ctribe/ECE411-Project/411 Project/nocLock/Graphics/Green_nocLock.JPG

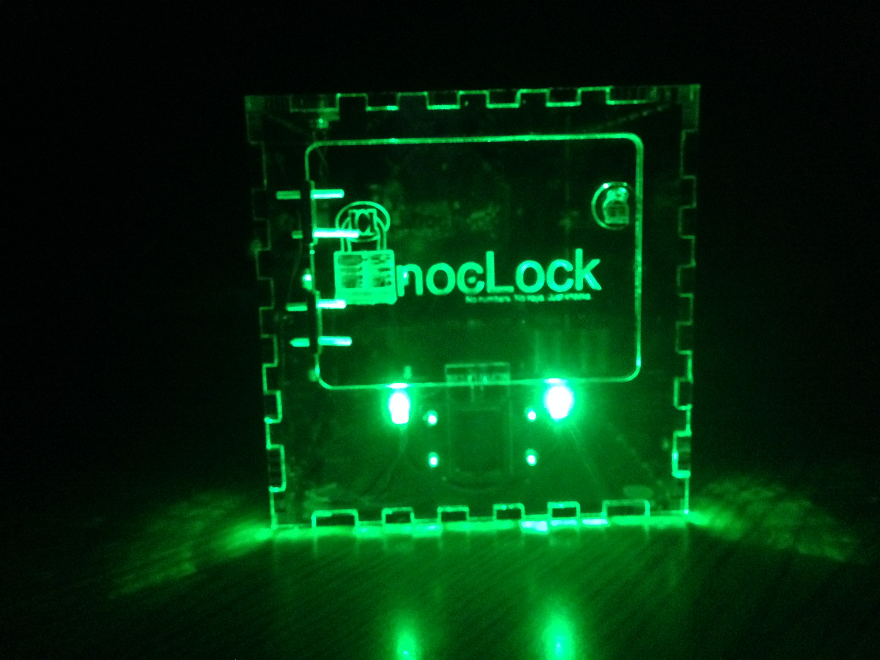
411 Project/nocLock/Graphics/Green_nocLock.JPG
