ctribe/ECE411-Project/411 Project/nocLock/Documentaion/Requirements/nocLock-Requirements.docx

# nocLock Requirements

# Must:

-Unlock with correct knock sequence

-Sense and differentiate knocks from non-knocks

-Store knocks in nonvolatile memory

-Box for locking

-Be able to be locked again

-Have power supply

-Be capable of visual or audio queues for confirmation.

-Have 2-layer PCB with majority surface mount components.

# Should:

-Include enclosure for PCB

-Require user to confirm knock sequence prior to saving

# May:

-Detect two discrete intensities of knocks for added security.

-Have battery-back up and recharging capabilities.
