ctribe/ECE411-Project/411 Project/nocLock/000-Sofware Files/T02_nocLock_Documentation.odt

Knock Lock Program documentation

The inside button will be on PORTB0. The outside button will be on PORTB1. The reset button will be on PORTB6 The inside button controls recording of a new knock sequence, while the outside button signals that someone wants to open the box. The reset button clears EEPROM and returns to the initial state with no knock stored. The locking solenoid will be on PORTB2. The green LED is on PORTB3 and the red LED is on PORTB4. We want the buttons to be an input (0) and the solenoid/LEDS to be an output (1), Thus, the DDRB register should be set as 0x02:

Bit 7 | Bit 6 | Bit 5 | Bit 4 | Bit 3 | Bit 2 | Bit 1 | Bit 0
0 | 0 | 0 | 1 | 1 | 1 | 0 | 0
1 | | | | C

The buttons are active high, so no pull up resistors are needed, and the solenoid must be initially off. The PORTB register looks like this when the solenoid is off:

Bit 7 | Bit 6 | Bit 5 | Bit 4 | Bit 3 | Bit 2 | Bit 1 | Bit 0
0 | 0 | 0 | 0 | 0 | 0 | 0 | 0
0 | | | | 0

Similarly, when the solenoid is on, the PORTB register looks like this:

Bit 7 | Bit 6 | Bit 5 | Bit 4 | Bit 3 | Bit 2 | Bit 1 | Bit 0
0 | 0 | 0 | 0 | 0 | 1 | 0 | 0
0 | | | | 4

The PINB register holds the current state of the ports. In this case, when the inside button is pressed, bit 0 will be a 1. When the outside button is pressed, bit 1 will be a 1. When the reset button is pressed, bit 6 will be a 1. All buttons are active high.

In the CLKPR register, set the CLKPCE bit. Immediately after, set the CLKPR register to 0. This changes the clock divisor to 1, giving us a 8MHz internal clock.

For the timer, we need to set the CTC bit in the TCCR0A register. This will clear the timer and restart it every time the timer reaches the value we want. This allows us to interrupt every 1ms.

Setting the OCR0A (compare) register to 125 makes the timer generate an interrupt every 1ms. Can use this site here to calculate the ticks: http://eleccelerator.com/avr-timer-calculator

To enable an interrupt every time our compare value is met, we need to set bit OCIE0A in the TIMSK0 register. We also need to include the <avr/interrupt.h> library and use the sei() function to enable global interrupts. Use cli() to disable global interrupts.

We then need to set the pre-scaler to 64 in the TCCR0B register. To do this, we set CS01 and CS00 to a 1. This starts the counter, so set it last.

The ISR() function is the interrupt service routine. This is what is used to increment the counter for how many milliseconds we are currently at. We need to use TIMER0_COMPA_vect in the ISR() to check for the interrupt.

Currently, the maximum number of knocks is 100. That could change, though. The function that compares the two knock sequences to unlock the door has a threshold of 200ms on each side of the stored value currently. This gives the user a 400ms window to input each of the knocks in the sequence.

Use the ADMUX register to setup the A to D converter reference voltage and choose the correct signal. I'm using ADC 5 currently and we need to set bit 6 to a 1 and bits 2 and 0 to a 1 for channel 5.

Next, I need ADCSRA register. The ADC uses interrupts, so we set that here. We need to set ADEN, which enables the ADC. Also need to set the ADIE bit to enable interrupts from the ADC. We then need to set the pre-scalar value to the max of 128. To do this, set ADPS0-2.

Final thing we need is to disable digital input buffer in the DIDR0 register. To do this, set the ADC5D bit in the register.

At startup, the outside button will open the solenoid for 5 seconds. The inside button will program a knock sequence. Once the knock sequence has been confirmed, the sequence will be written to eeprom and the box will lock. Pressing the outside button will now wait for the knock sequence to be entered. If the sequence matches, the solenoid opens for 5 seconds. Pressing the inside button will again record a new knock sequence in the same way it did before.

Pressing the reset button erases eeprom and resets the program back to its initial state. The outside button will open the door again for 5 seconds and the inside button will program a new knock. The reset button is located inside, so people cannot use it to break into the box.
