ctribe/ECE411-Project/411 Project/nocLock/Documentaion/Presentation/T02_PresentationRev4.pptx

## T02 nocLock

Travis, jaime, Sean, Cameron

## Agenda

- Project Motivation and Need
- Design
- Implementation
- Testing
- Results
- Contributions and Lessons Learned
- Q/A
- Demo

## Problem & Objective

- Problem: Create an interesting alternative to traditional locking methods.
- Objective: Work as a team to design, construct, and demonstrate a prototype that fulfills course requirements.

## Possible Solution

1. RFID
2. Card Key
3. NES controller
4. Biometric Scanner

## Our Solution

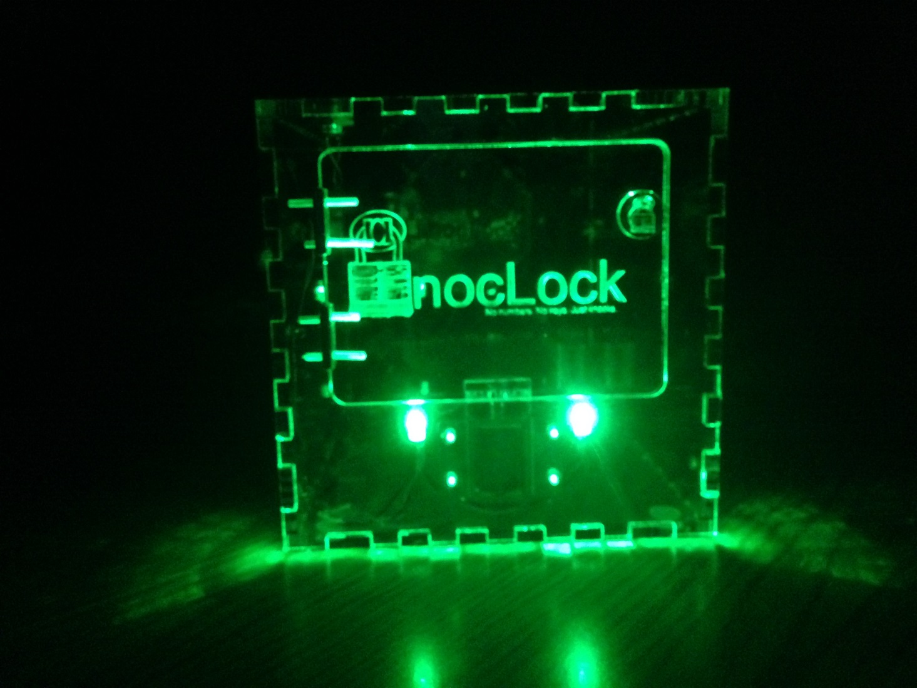
[picture p10: figure]

## Requirements

- Device must lock and unlock.
- Device must differentiate between many distinct knock sequences.
- Device must be reliable. (i.e. stay locked/unlocked when expected)
- Device should be user friendly and intuitive.
- Device must be safe to operate.
- Device must be durable.

## Approach/Overview of Project

- Made decisions as a group
  - Multiple Decision Methods
- Work was done by teams of two
  - Design
  - Verification
- Consistent meeting times
  - Met every Friday

## Inspiration & Research

- Inspiration
  - Idea inspired by Adafruit ‘Secret Knock Detector’
- Research
  - Bob Pease
    - Solenoid driver circuit
  - Various Youtube Videos
    - Working with AVR
    - Timers, ADC, Interrupts, etc.

## System Design

## Design Approach

- Started with top down design
- Block Diagram/Flow Chart
- Modular design methodology
- Concurrent Engineering

## Hardware Level 0/Level 1

## Sensor Input

- Piezo element for knock
sensor.
- Protects uC from >5v

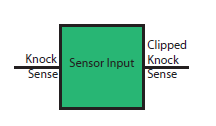
[picture p11: figure]

## Unlock Module

- Depends on lock
- Deliver large current
to solenoid.
- Various driver options
  - Relay
  - Darlington Pair
  - MOSFETs

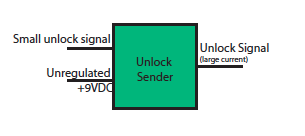
[picture p12: figure]

## Microcontroller

- Central Module
- Various choices
  - Cost
  - Simplicity
  - Availability
- Decided lowest cost as primary concern

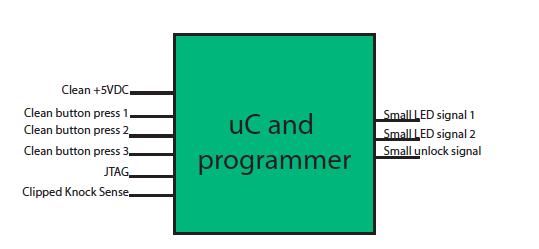
[picture p13: figure]

## Slide 15

Software Flowchart


## Software Algorithms

- Knock Detection
  - ADC threshold
  - Knock Sensor Debounce
  - Timer starts after initial knock
  - Each Knock is stored at current time value
  - Knock combination is a collection of times
- Knock Compare
  - Compare number of knocks
  - Compare timer values

## Software Implemtation

## Read Knocks

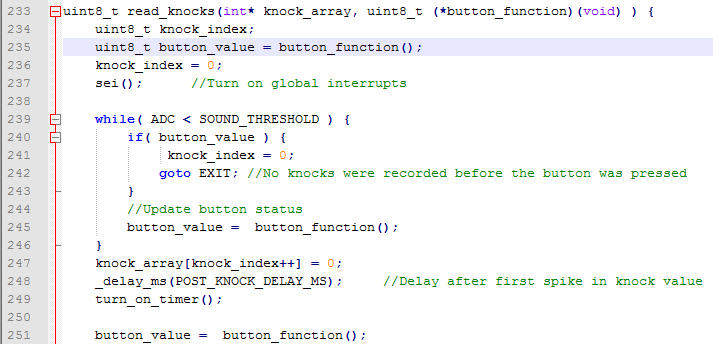
[picture p14: figure]

## Read Knocks cont.

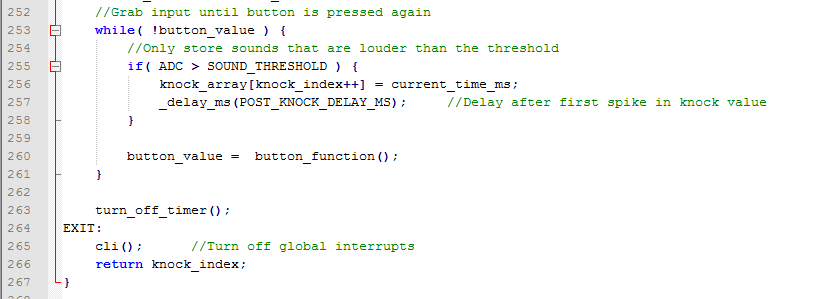
[picture p15: figure]

## Compare Knocks

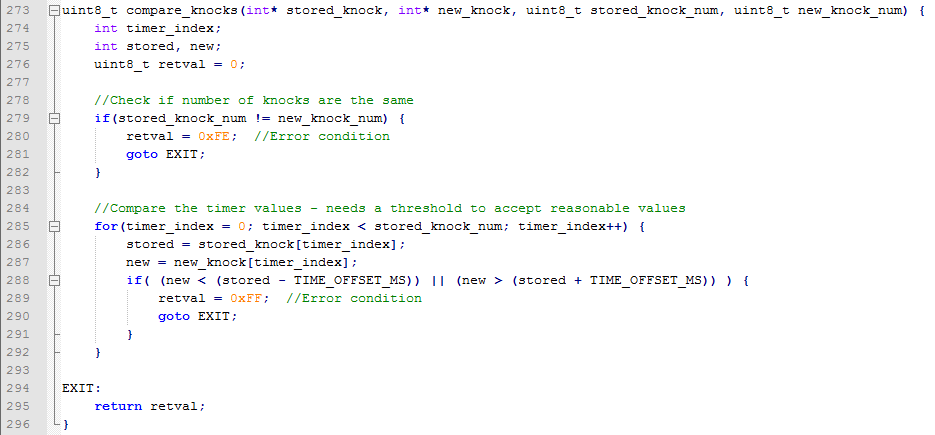
[picture p16: figure]

## Hardware Implementation

## Knock Sense Subsystem

- Protection diode clips voltage
- Current drain
- Connects via connector

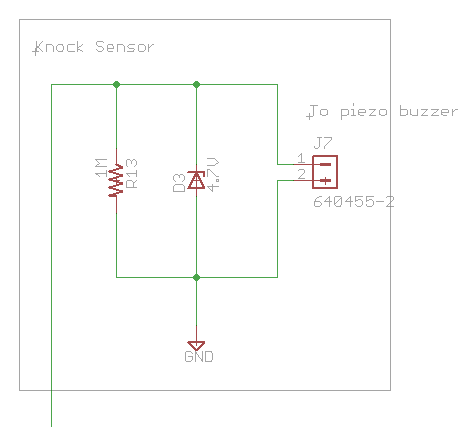
[picture p17: figure]

## Slide 23

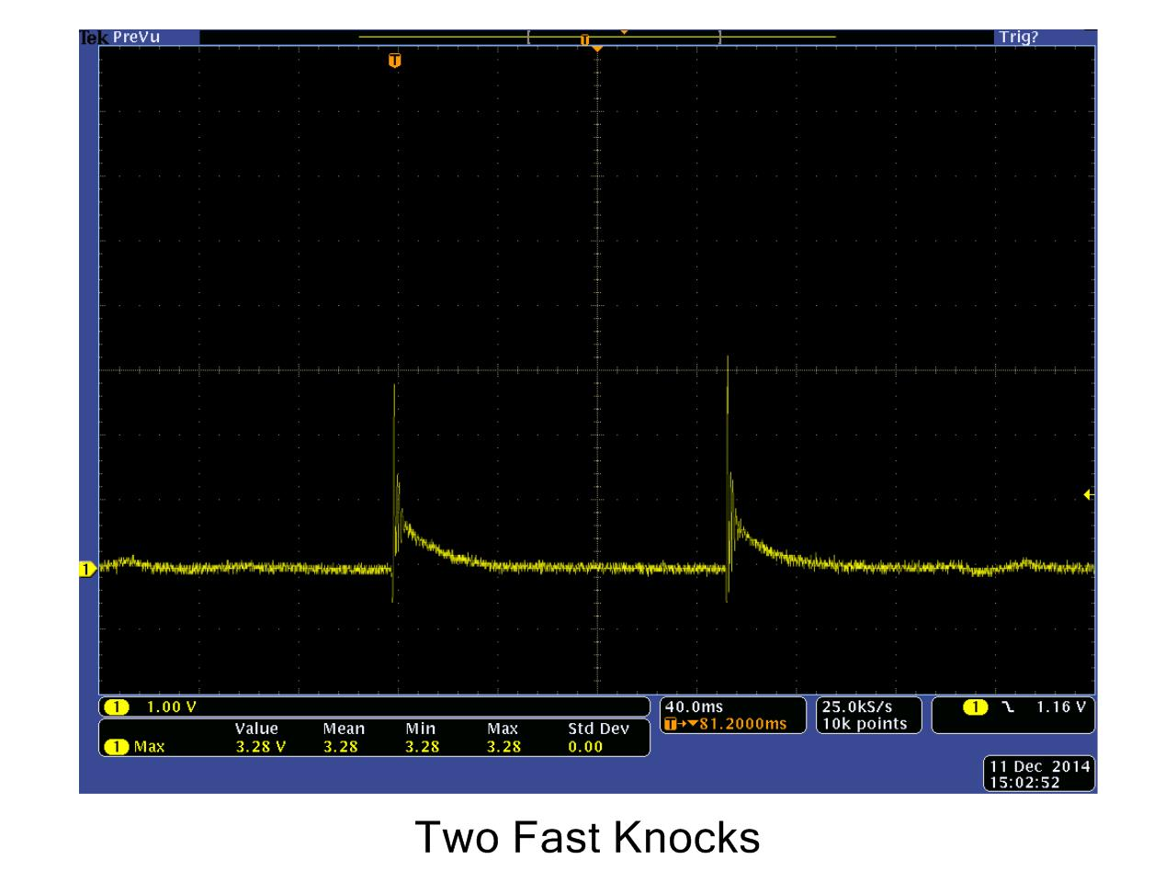
[picture p18: figure]

## Solenoid Subsystem

- MOSFET Switch
- Clamp diode
- Lowers voltage drop across solenoid
- Reduction of current consumption from 600mA to 300mA

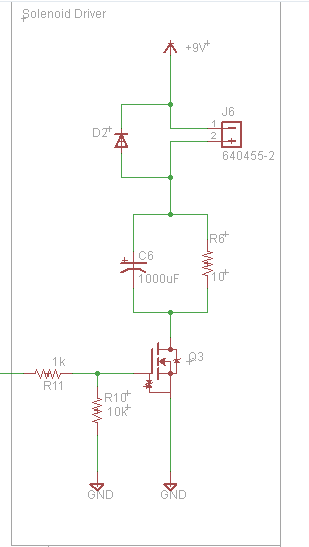
[picture p19: figure]

## Slide 25

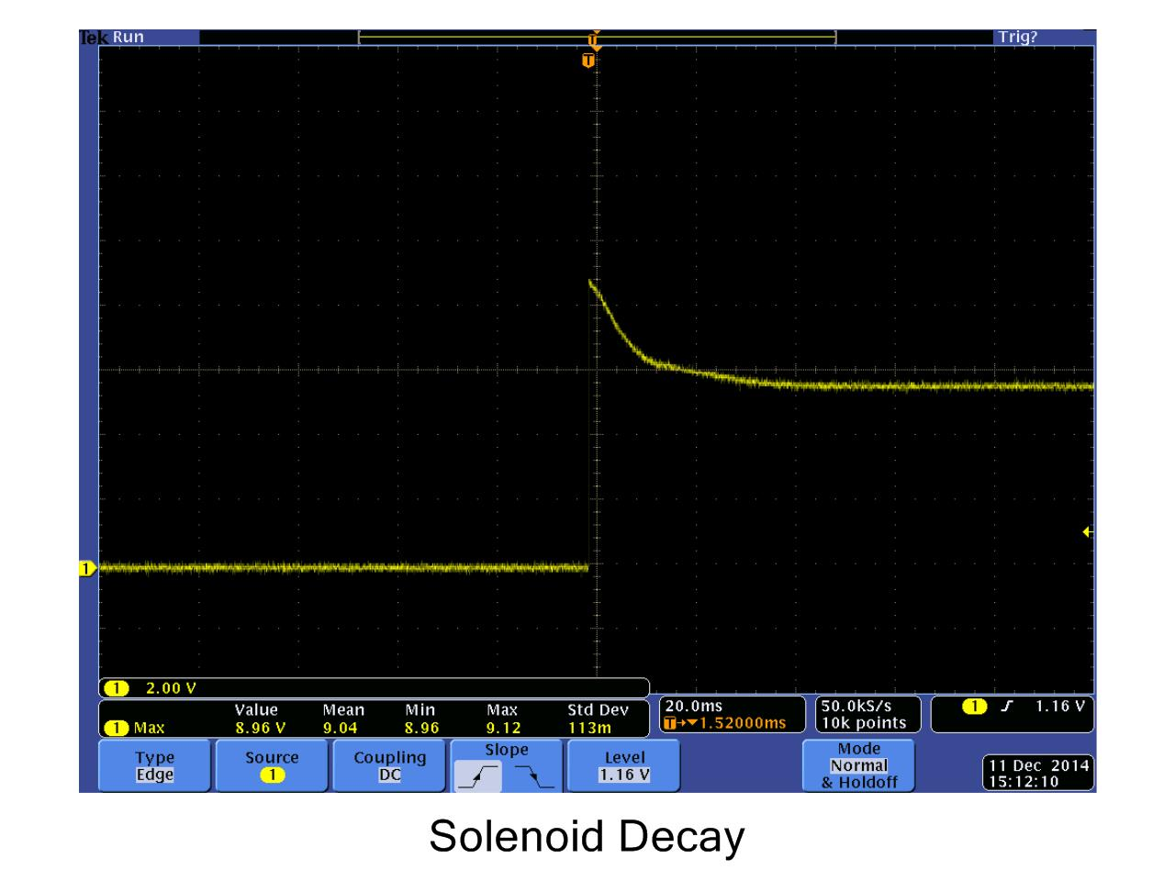
[picture p20: figure]

## Microcontroller Subsystem

- ATMega 88A
- Isolated digital/ADC power supplies
- Low cost and adequate memory
  - EEPROM too
- Dev. tools available

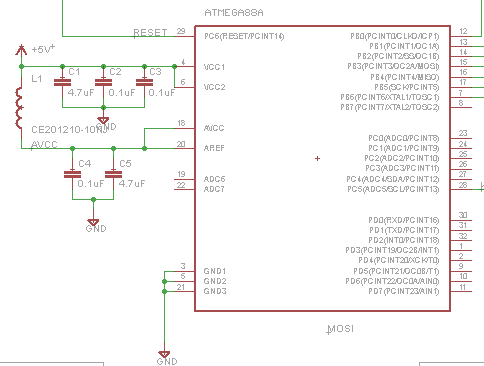
[picture p21: figure]

## PCB Layout

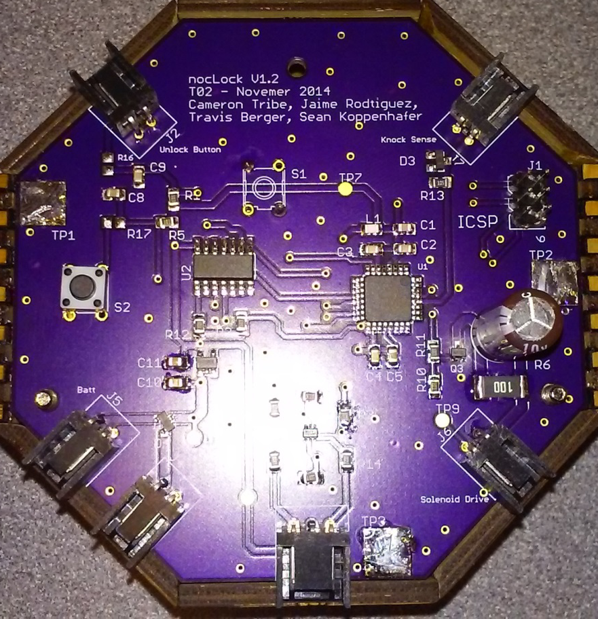
[picture p22: figure]
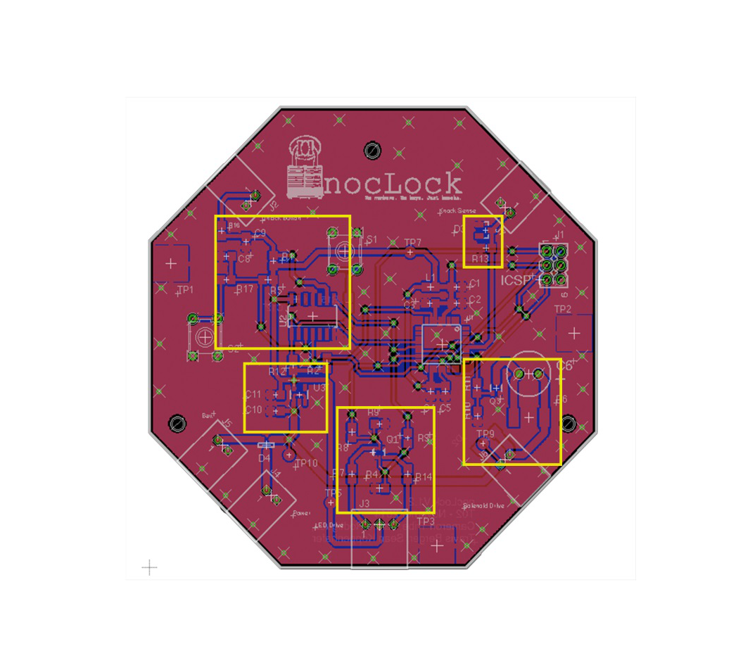
[picture p23: figure]

Button
Inputs

Sensor
input

Power
Supply

Solenoid

LED’s

## PCB Enclosure

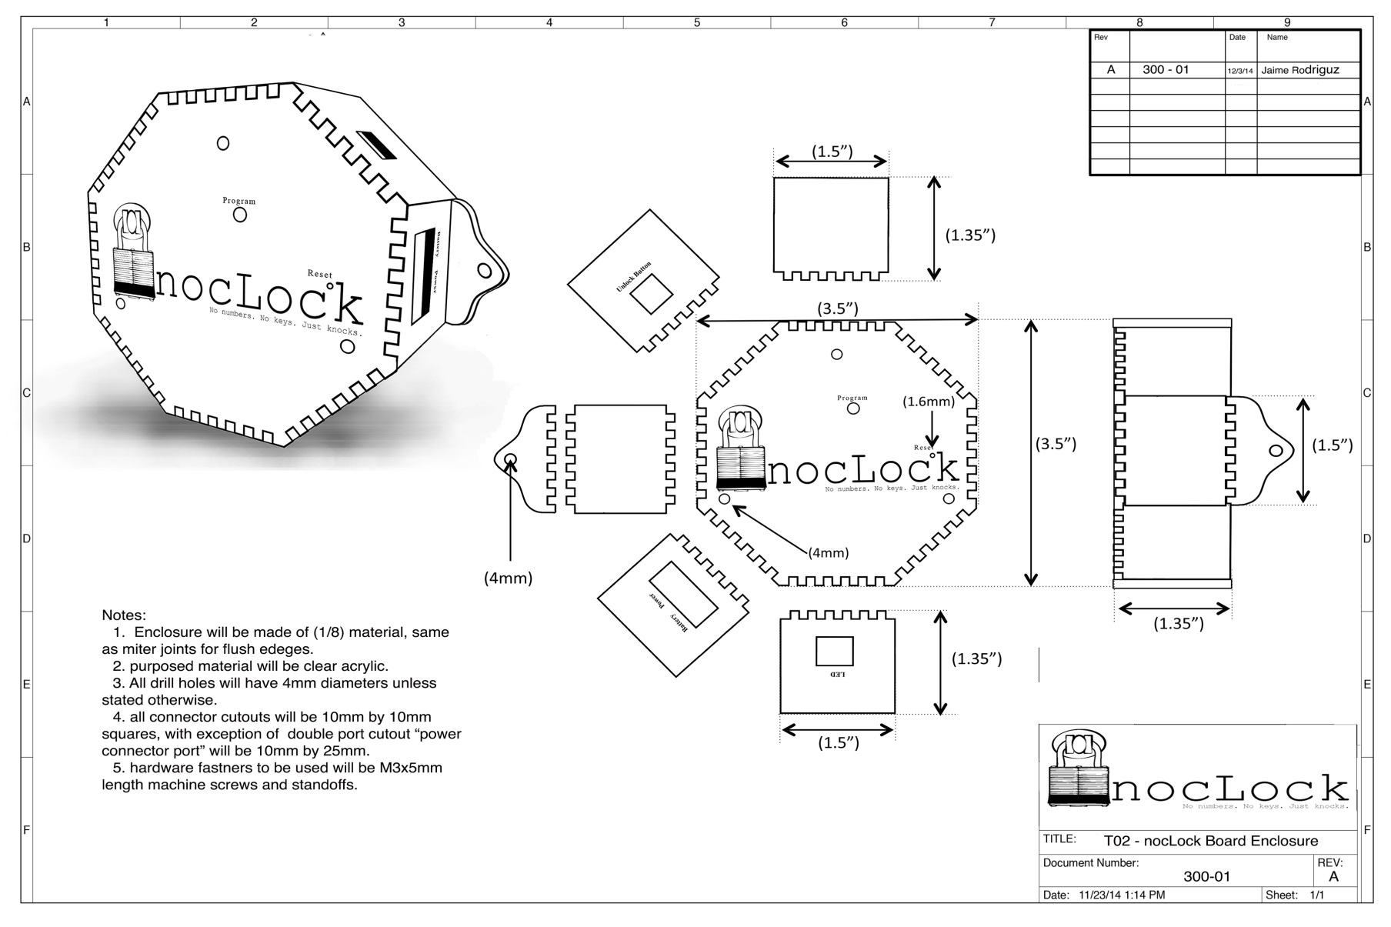
[picture p24: figure]

## Testing

## Testing Overview

- Concurrent Engineering
  - Verification
  - Characterization
- Test Categories
  - Modular Testing
  - Software Testing
  - Integration Testing
  - User Testing

## Concurrent Engineering

- Verification
  - Testing was started during the design phase in order to verify designs
  - When any changes were made to a design, the new design was verified before integrating that design with anything else
- Characterization
  - Characterized performance of key components

## Test Categories

- Modular Tests
  - Modular Testing was done to remove as many variables as possible in order to identify bugs/problems
  - Module test passes were prerequisites for larger integration tests.
- S0ftware Testing
- Integration Tests
  - Integrated modules and tested performance of entire system.
  - Started by using stubs to simulate integration.
- User Testing
  - Observed beta testing of project.

## Results

- Things that worked on the board:
  - Solenoid Driver circuit
  - Power Supply
  - LED Driver
- Things that DIDN’T work on the board
  - Buttons
  - Software for buttons
    - Program button
  - ICSP

## Results

- Things that worked in our group:
  - Communication
  - Work balance
  - Flexibility
- Things that DIDN’T work in our group
  - Github for schematics
  - Working too soon
  - Communication

## Contributions

- Cameron
- Travis
- Sean
- Jaime

## Lessons - Cameron

- Eagle CAD
  - Library management
  - PCB Layout
  - Schematic Drawing
- Simple CAD drawings
- EPL equipment
- Microcontroller interfacing
- Project management
