ctribe/ECE411-Project/411 Project/nocLock/Documentaion/Presentation/T02-Presentation-Cameron.pptx

## Prior Work

- Adafruit
  - Main project idea only
  - No code
  - Ideas for circuits
- Bob Pease
  - Solenoid snubber circuit

## Design: Hardware

- Level 0/Level 1 Block diagram
