ctribe/ECE411-Project/411 Project/nocLock/Documentaion/WPR/wk5/T02_WPR_Berger_11_23.docx

Weekly Progress Report

T02

Travis Berger

Week ending 11/23/2014

Completed Tasks:

1. Developed test plan and a test case for board testing and homework assignment.
2. Assembled two PCB’s and tested using test plan.
3. Reviewed PCB enclosure design before fabrication.

Tasks to Be Completed Next Week:

1. Put together and test a fully completed prototype in final enclosure.
2. Finish assembling the other PCB’s.
3. Fix any problems that arise from enclosure.
4. Help debug problem with software during unlock mode.
