ctribe/ECE411-Project/411 Project/nocLock/Documentaion/WPR/wk4/WPR_Berger_11_16.docx

Weekly Progress Report

T02

Travis Berger

Week ending 11/16/2014

Completed Tasks:

1. Layed out basic structure of final presentation.
2. Completed System Design and Modeling homework assignment.
3. Reimbursed Cameron Tribe for purchasing components and boards.
4. Received board 11/14. Powered up board and tested resulting in a few board modifications which are doable and won’t affect time schedule.

Tasks to Be Completed Next Week:

1. Develop test plan for board testing and homework assignment.
2. Assemble all PCB’s and test using test plan.
3. Review PCB enclosure design before fabrication.
