ctribe/ECE411-Project/411 Project/nocLock/Documentaion/WPR/wk3/WPR_Berger_11_9.docx

Weekly Progress Report

T02

Travis Berger

Week ending 11/9/2014

Completed Tasks:

1. Installed Microsoft Project and familiarized myself with the software.
2. Created Project Schedule.
3. Reviewed teammates PCB layout and verified it.

Tasks to Be Completed Next Week:

1. Layout basic structure of final Presentation.
2. Complete System Design and Modeling homework assignment.
3. Reimburse Cameron Tribe for purchasing components and boards.
4. Start board assembly if boards come back from OSH Park.
