ctribe/ECE411-Project/411 Project/nocLock/Documentaion/System Design/L0-L1.pdf

# nocLock

Knock Sense
Programmer

Battery +9VDC
Wall Wart +9VDC
Button 1
Button 2
Button 3
Knock Sense
Programmer

LED 1

(large current)
LED 2

(large current)
Unlock Signal

(large current)

# Level 0:

# Level 1:

uC and
programmer

LED
Driver
1

LED
Driver
2

Internal
Power Supply

Unlock
Sender

Sensor Input

## nocLock

Battery +9VDC
Wall Wart +9VDC

Button 1

Button 2
Button 3

Knock Sense

Programmer

LED 1
(large current)

LED 2
(large current)

Unlock Signal
(large current)

Source
Selection

Button
Debounce 1

Button
Debounce 2

Button
Debounce 3
