ctribe/ECE411-Project/411 Project/nocLock/Documentaion/System Design/L1-L0.pdf

# uC and programmer

LED
Driver
n

Button
Debounce
n

Internal
Power Supply

Unlock
Sender

Sensor Input

Button n | Clean button press
Clean +5VDC

Small unlock signal

Small LED signal

Knock
Sense

Clipped
Knock
Sense

Clean +5VDC
Clean button press 1
Clean button press 2
Clean button press 3
JTAG
Clipped Knock Sense

Small LED signal 1
Small LED signal 2
Small unlock signal

# Level 0:

## of previous L1

Source
Selection

Battery +9VDC
Wall Wart+9VDC | Unregulated
| +9VDC

Unregulated
+9VDC

Unregulated
+9VDC

Unlock Signal
(large current)

LED n
(large current)
Clean +5VDC
