ctribe/ECE411-Project/411 Project/nocLock/Documentaion/Presentation/T02_PresentationRev2.pptx

## T02 nocLock

Trampus, Jaimus, Shampus, Cameronmpus

## Agenda

- Project Motivation and Need
- Design
- Implementation
- Testing
- Results
- Contributions and Lessons Learned
- Q/A
- Demo

## Problem & Objective

- Problem: Create an interesting alternative to traditional locking methods.
- Objective: Work as a team to design, construct, and demonstrate a small project that fulfills course requirements.

## Possible Solution

1. RFID
2. Card Key
3. NES controller
4. Biometric Scanner

## Our Solution

- <PICTURE PENDING>

## Requirements

- Device must lock and unlock.
- Device must differentiate between many distinct knock sequences.
- Device must be reliable. (i.e. stay locked/unlocked when expected)
- Device should be user friendly and intuitive.
- Device must be safe to operate.
- Device must be affordable.
- Device must be durable.

## Approach/Overview of Project

- Made decisions as a group
  - Multiple Decision Methods
- Work was done by teams of two
  - Design
  - Verification
- Consistent meeting times
  - Met every Friday

## Inspiration & Research

- Inspiration
  - Idea inspired by Adafruit ‘Secret Knock Detector’
- Research
  - Bob Pease
    - Solenoid snubber circuit
  - Various Youtube Videos
    - Working with AVR
    - Timers, ADC, Interrupts, etc.

## System Design

## Design Approach

- Started with top down design
- Block Diagram/Flow Chart
- Modular design methodology
- Concurrent Engineering

## Hardware Level 0/Level 1

## Power source select

- Instant Backup
- Option for charging
- Decided to opt out of battery charging
  - Lower parts count
  - Lower total cost
  - Decided it would be unnecessary

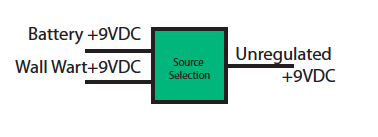
[picture p25: figure]

## Unlock Sender

- Depends on lock
- Deliver large current
to solenoid.
- Various driver options
  - Relay
  - Darlington Pair
  - Mosfet


## Internal power supply

- Produce a clean
voltage supply.
- IC regulators
- Low cost as possible

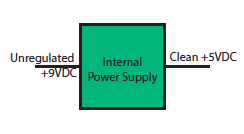
[picture p26: figure]

## LED Driver

- General purpose
switching.
- LED types
  - Individual LEDs
  - Common Anode

## Button Debounce

- Remove button bounce
- Could have been S/W
- Decided to include hardware debounce functionality.

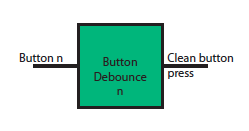
[picture p27: figure]

## microcontroller

- Central Module
- Various choices
  - Cost
  - Simplicity
  - Availability
- Decided lowest cost as primary concern


## Slide 18

Software Flowchart


## Software Algorithms

- Knock Detection
  - ADC threshold
  - Knock Sensor Debounce
  - Timer starts after initial knock
  - Each Knock is stored at current time value
  - Knock is a collection of times
- Knock Compare
  - Compare number of knocks
  - Compare timer values

## Implementation

## Microcontroller Subsystem

- ATMega 88A
- Isolated digital/ADC power supplies
- Low cost and adequate memory
  - EEPROM too
- Dev. tools available


## Solenoid Subsystem

- MOSFET Switch
- Clamp diode
- Lowers voltage drop across solenoid
- Reduction of power consumption from 400mA to 200mA


## Knock Sense Subsystem

- Protection diode clips voltage
- Current drain
- Connects via connector

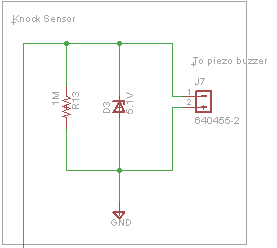
[picture p28: figure]

## Button Debounce

- RC circuit for smoothing bounces.
- Schmidt trigger to create a fast rising edge
- Combination removes button bounces

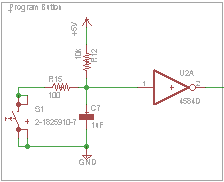
[picture p29: figure]

## LED Driver Subsystem

- Dual MOSFET
- Designed to drive a common anode LED
  - Bi-Color LED
- Connector allows exchangeable LEDs

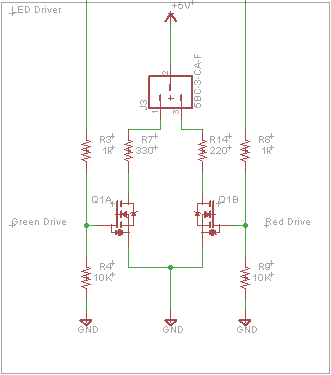
[picture p30: figure]

## PCB Layout


Button
Inputs

Sensor
input

Power
Supply

Solenoid

LED’s

## PCB Enclosure


## Lock Box Design

## Read Knocks


## Read Knocks cont.


## Compare Knocks


## Testing

## Testing Overview

- Concurrent Engineering
  - Verification
  - Characterization
- Test Categories
  - Modular Testing
  - Software Testing
  - Integration Testing
  - User Testing

## Concurrent Engineering

- Verification
  - Testing was started during the design phase in order to verify designs
  - When any changes were made to a design, the new design was verified before integrating that design with anything else
- Characterization
  - Characterized performance of key components

## Test Categories

- Modular Tests
  - Modular Testing was done to remove as many variables as possible in order to identify bugs/problems
  - Module test passes were prerequisites for larger integration tests.
- S0ftware Testing
- Integration Tests
  - Integrated modules and tested performance of entire system.
  - Started by using stubs to simulate integration.
- User Testing
  - Observed beta testing of project.

## Results

- Things that worked on the board:
  - Solenoid Driver circuit
  - Power Supply
  - LED Driver
- Things that worked in our group:
  - Communication
  - Work balance
  - Flexibility

## Results

- Things that DIDN’T work on the board
  - Buttons
  - Software for buttons
    - Program button
  - ICSP
- Things that DIDN’T work in our group
  - Github for schematics
  - Working too soon
  - Communication
  - Not enough work

## contributions

- Cameron
- Travis
- Sean
- Jaime

## Lessons - Cameron

- Eagle CAD
  - Library management
  - PCB Layout
  - Schematic Drawing
- Simple CAD drawings
  - EPL equipment
- Microcontroller interfacing
- Project management
