ctribe/ECE411-Project/411 Project/nocLock/Documentaion/Presentation/T02_Presentation.pptx

## T02 nocLock

Trampus, Jaimus, Shampus, Cameronmpus

## Overview of Presentation

- Problem/need
- Design
- etc

## Problem

- Create an interesting alternative to traditional locking methods. < Wording will change>
- Novelty device that is cool.
- Most likely put in proposal or whatever the ambiguous statement is.

## Objectives

- Work as a team to design, construct, and demonstrate a small project.

## Requirements

- Device must lock and unlock.
- Device must differentiate between many distinct knock sequences.
- Device must be reliable. (i.e. stay locked/unlocked when expected)
- Device should be user friendly and intuitive.
- Device must be safe to operate.
- Device must be affordable.
- Device must be durable.

## Approach/Overview of Project

- Made decisions as a group using decision tables with weighted votes for team members. <prob not use this>
- Broke team into two main groups, usually had one partner tackle initial design and one partner verify and help debug design.

## Design

- Top down design based off of Use-Case diagram.
- Created block diagram which helped to isolate different subsystems.
- Designed with a modular approach by designing each subsystem separately.

## Use-Case Map

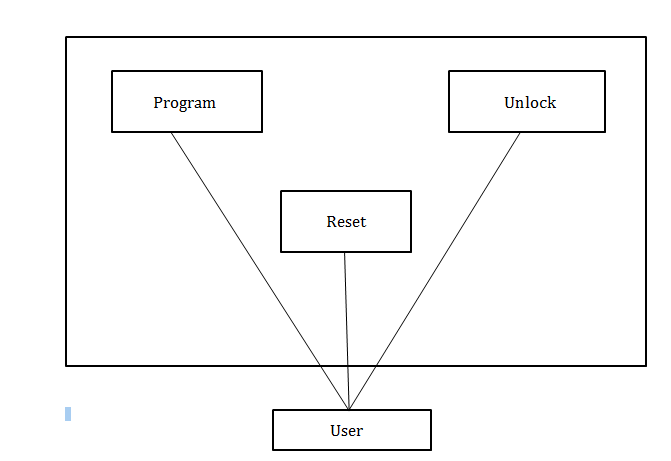
[picture p31: figure]

## Block Diagram


## Solenoid Subsystem

- Overall Design
- Key Parameters inputs outputs etc.
- Integrates with following sub systems: Microcontroller, etc.
- Alternatives: Darlington Pair, Charge Pump.


## Microcontroller Subsystem

- Overall Design
- Key Parameters inputs outputs etc.
- Central Hub integrates with all sub systems.
- Alternatives: Chose this one because we had one, and costs, performance.


## Button System

- Overall Design
- Key Parameters inputs outputs etc.
- Integrates with following sub systems: Microcontroller, etc.
- Alternatives: Darlington Pair, Charge Pump.


## LED Driver Subsystem

- Overall Design
- Key Parameters inputs outputs etc.
- Integrates with following sub systems: Microcontroller, etc.
- Alternatives: Darlington Pair, Charge Pump.

## Knock Sense Subsystem

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

## Software

## Testing

- Testing started with modular testing. This was done to verify design and helped to find bugs in an easier to debug isolated system.
- LED’s were used as stubs in order to integrate the hardware with the software and step through the code.

## Major Setbacks/Bugs

- Button Debounce
- CPU clock speed
- Program Mode
- Knock Sense threshold <voltage>
- Knock Sense Delay <time>
