ctribe/ECE411-Project/411 Project/nocLock/Documentaion/System Design/Blockdiagram.png

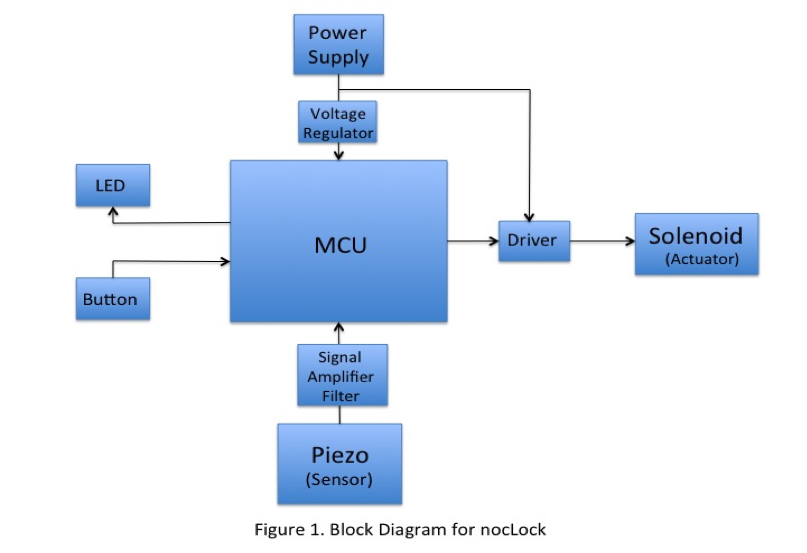
411 Project/nocLock/Documentaion/System Design/Blockdiagram.png
