ctribe/ECE411-Project/411 Project/nocLock/Documentaion/System Design/L1-L0.png

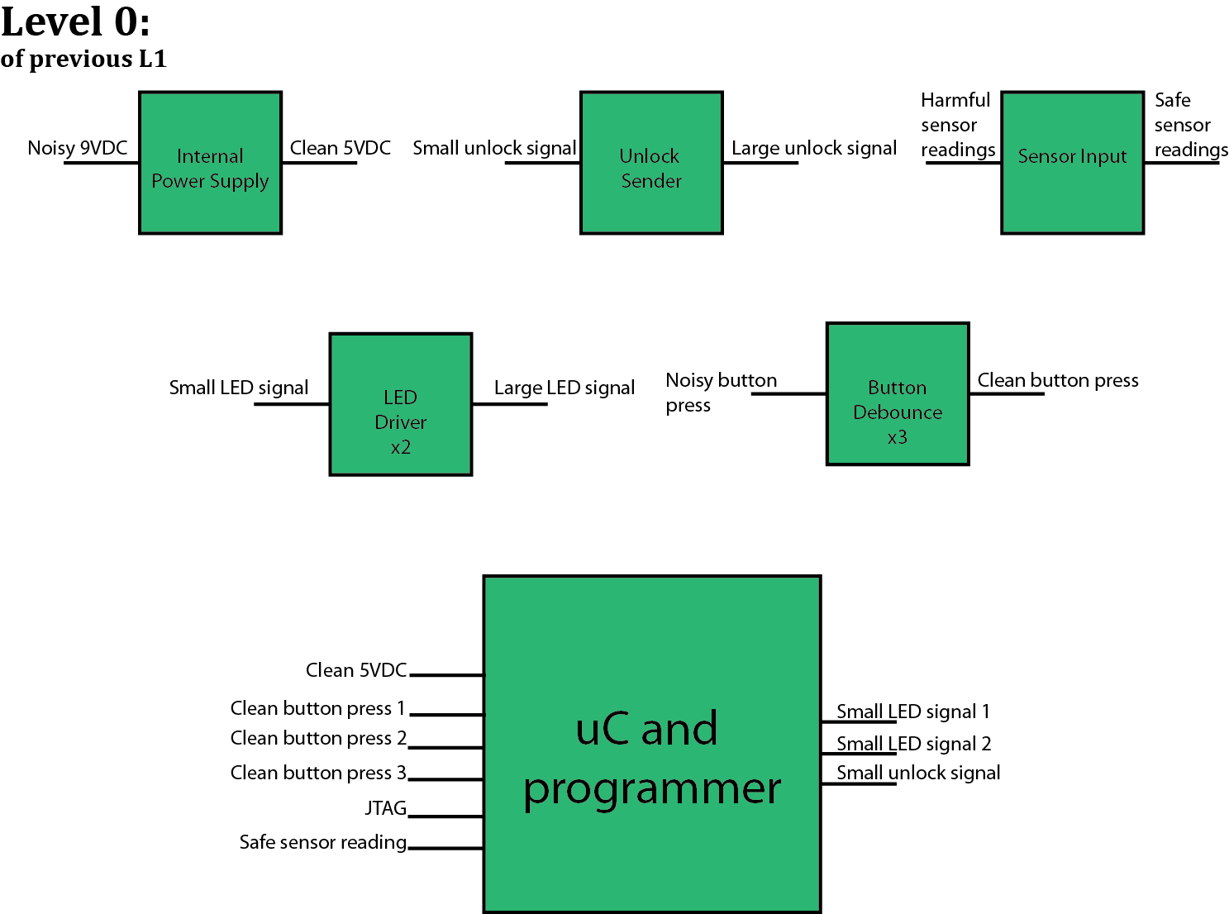
411 Project/nocLock/Documentaion/System Design/L1-L0.png
