ctribe/ECE411-Project/411 Project/nocLock/Graphics/Board.png

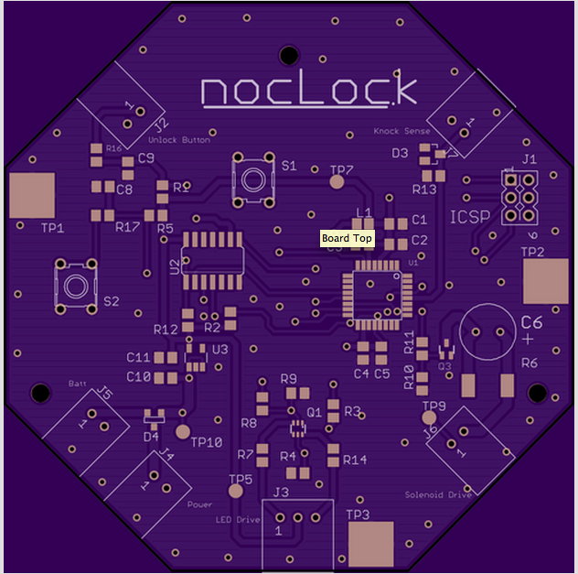
411 Project/nocLock/Graphics/Board.png
