ctribe/ECE411-Project/411 Project/nocLock/Graphics/V1.1Board.png

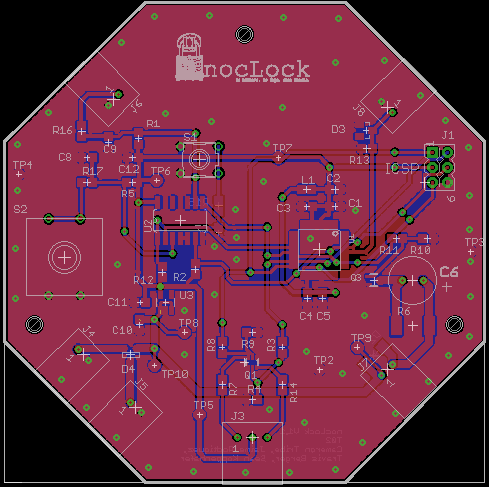
411 Project/nocLock/Graphics/V1.1Board.png
