ctribe/ECE411-Project/411 Project/nocLock/Graphics/Logo/KnockLockLogo.dxf

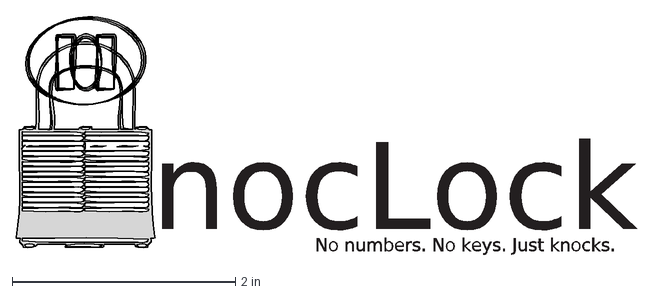
[picture p37: CAD file, 2014-11-10]
411 Project/nocLock/Graphics/Logo/KnockLockLogo.dxf
nocLock
No numbers. No keys. Just knocks.
