ctribe/ECE411-Project/411 Project/nocLock/Documentaion/T02-NocLock_user_manual.docx

NocLock User Manual

First Time Setup

When you first get the NocLock, no knock sequence will be programmed. This allows the user to easily program a knock sequence without having to first enter in a pre-programmed knock sequence from the factory. To program the NocLock with a knock sequence, follow these steps:

1. Press the outside “action” button to open the door of the box.
2. The LED will turn green and the door will unlock for five seconds.
3. Press the inside “program” button, located on the enclosure on the back wall of the box.
4. The LED should now turn yellow, signifying that the NocLock is in program mode. If you would like to exit program mode, press the “program” button again BEFORE entering a knock sequence.
5. Enter in a knock sequence that would like to program the NocLock with.
6. Press the “program” button.
7. The LED will turn green for two seconds, signifying that your knock sequence was recognized.
8. The LED will turn yellow again.
9. The user must now confirm their knock sequence from step 5 before the knock sequence is accepted. Re-enter the same knock sequence from step 5.
10. Press the “program” button.
11. If the knock sequences match, the LED will turn green for two seconds and then turn red. The knock has now been programmed and the box is locked.
12. If the knock sequences do not match, the LED will blink red three times before returning to the initial setup state. Re-start from step 3.

If you successfully programmed your knock sequence, the NocLock will remember your knock sequence until you reprogram the NocLock with a new knock sequence.

Unlocking The NocLock

To unlock the NocLock, you must enter in the currently programmed knock sequence. To do this, follow these steps:

1. Press the outside “action” button.
2. The LED will turn yellow, signifying that the NocLock is listening for knocks. If you would like to exist unlock mode, press the “action” button again BEFORE entering any knocks.
3. Enter the currently programmed knock sequence.
4. Press the outside “action” button.
5. If the knock sequence matches the programmed knock sequence, the LED will turn green and the door will unlock for five seconds.
6. If the knock sequence does not match the programmed knock sequence, the LED will blink red three times before returning to the locked state.

Re-programming The NocLock

If you would like to re-program the NocLock with a new knock sequence, follow these steps:

1. Unlock the box. Follow the steps listed in the section “Unlocking the NocLock”.
2. Press the inside “program” button, located on the enclosure on the back wall of the box.
3. The LED should now turn yellow, signifying that the NocLock is now in program mode. If you would like to exit program mode, press the “program” button again BEFORE entering a knock sequence.
4. Enter in a knock sequence that would like to program the NocLock with.
5. Press the “program” button.
6. The LED will turn green for two seconds, signifying that your knock sequence was recognized.
7. The LED will turn yellow again.
8. The user must now confirm their knock sequence from step 5 before the knock sequence is accepted. Re-enter the same knock sequence from step 4.
9. Press the “program” button.
10. If the knock sequences match, the LED will turn green for two seconds and then turn red. The knock has now been programmed and the box is locked.
11. If the knock sequences do not match, the LED will blink red three times before returning the locked state. If the knock sequences do not match, the original knock sequence will still be stored in the NocLock.

Resetting the NocLock

If for any reason you would like to return to the initial setup state where no knock sequence is programmed, follow these steps:

1. Unlock the box. Follow the steps listed in the section “Unlocking the NocLock”.
2. Use a pin or something small to press the reset button located in the hole in the enclosure at the back of the box.
3. Wait a few seconds for the NocLock to reset itself.

The NocLock will now be in it's initial, factory state.
