ctribe/ECE411-Project/411 Project/nocLock/Documentaion/Test Plan/T02-System_Reliability_test.docx

nocLock System Reliability Test

Test ID: Test Case ?.?

Test Description:

This procedure has been created to test the reliability and robustness of the nocLock system as it is implemented in a general use- case scenario, this test will be accomplished by setting up the entire system to replicate a real life situation. The piezo sensor will be secured to an acrylic board to simulate a knocking surface, which will then be used to repeatedly unlock and open system. This test will not only verify the systems capabilities of differentiating between knock sequences, but will also be crucial in evaluating the behavior of the system after prolonged use.

Equipment:

1. nocLock board
2. Piezo element
3. Solenoid
4. LED indicator
5. Unlock Button
6. 9VDC Voltage Source > 1500mA current rating
7. Acrylic knocking surface (quarter inch)

Reference:

1. T02_nocLock_rev3.sch (for reference)
2. T02 – Test Plan “Parametric Test”
3. T02 System setup diagram (for reference)
4. T02 nocLock general operation.

Setup:

Fully assemble system with all external peripherals as described in “System setup diagram” and securely attach piezo element to acrylic knocking surface. Prepare system by programming the nocLock with a simple 3-knock sequence with a 3 second delay between each individual knock.

Procedure:

- Connect all external peripherals (LED, Solenoid, Unlock button, sensor and power)
- Secure piezo element to knocking surface
- Confirm functionality of all sub-systems using parametric test section from test plan.
- Program system with knock; make sequence as simple as possible.

-Press program button

- knock, count to 3.

- knock, count to 3.

- knock, count to 3.

- Confirm knock sequence; reenter knock sequence.
- Begin testing; use table below for expected system behavior.

Step | Action | Expected Result | Pass/Fail | Comments
1. | Press unlock button | Led will turn from red to yellow to indicate system is listening
2. | Enter knock sequence | N/A
3. | Press unlock button again to end knocking | Led will turn green if knock is accepted, solenoid will engage. Led will turn red if knock is denied and return to stand- by

- Repeat unlocking procedure and record attempt in the form below, after completing test at normal pace, redo procedure without changing the programmed knock sequence but changing knocking pace.
- Vary the Knocking pace.
- slow pace.

- knock, count to 5.

- knock, count to 5.

- knock, count to 5.

- Fast pace.

- knock, count to 0.

- knock, count to 0.

- knock, count to 0.
