ctribe/ECE411-Project/411 Project/nocLock/Documentaion/Test Plan/T02-TestCase 4.1.docx

Function Test: Program Knock

Test ID: Test Case 4.1

Test Description: This function test checks that the basic function of programming a knock sequence is working correctly. To fully test the program function two identical knocks are used to simulate a success and two separate knocks are used to simulate a fail. To conduct this function test reference the Program Use-Case found in the T02 System Design document.

Equipment:

1. Oscilloscope
2. Digital Multi-meter
3. Function Generator
4. Two Channel DC Power Supply
5. AVR Dragon Board

Part(s):

1. Microcontroller module
2. Knock Sensor module
3. Solenoid Drive module
4. Program Button module
5. Unlock Button module
6. Erase EEPROM module
7. LED Sensor module

Reference:

1. T02_nocLock_rev3.sch
2. Test Case 1.1
3. Test Case 1.3
4. Test Case 1.4
5. Test Case 1.5
6. Test Case 1.7
7. Program Use-Case (T02 System Design.doc)

Setup:

The setup for this test case involves the Microcontroller module, Knock Sensor module, Solenoid Drive module, Program Button module, Unlock Button Module, Erase EEPROM module, and LED Sensor module. For instruction on how to setup individual modules refer to the modules test case and/or reference the nocLock Schematic. This test setup will mainly focus on the connections between each module and the microcontroller module.

1. Connect Microcontroller PC5 (Pin 28) to Knock Sense on the Knock Sensor.
2. Connect Microcontroller PB3 (Pin 15) to Green Drive on the LED Module.
3. Connect Microcontroller PB4 (Pin 16) to Red Drive on the LED module.
4. Connect Microcontroller PB0 (Pin 12) to Program on the Program Button Module.
5. Connect Microcontroller PB6 (Pin 7) to U1 on Erase EEPROM Module.

Procedure:

Step | Action | Expected Result | Pass/Fail | Comments
1. | Push Unlock Button. | LED turns green, solenoid activates for five seconds opening nocLock.
2. | Push Program Button | LED turns yellow.
3. | Enter Knock Sequence | LED remains yellow
4. | Push Program Button | LED turns green confirming knock entry, LED turns yellow.
5. | Re-enter Knock Sequence | LED turns green confirming new knock sequence has been successfully program.
6. | Press Reset Button | EEPROM gets Erased.
7. | Push Program Button | LED turns yellow.
8. | Enter Knock Sequence | LED remains yellow
9. | Push Program Button | LED turns green confirming knock entry, LED turns back to yellow.
10. | Enter Different Knock Sequence | LED turns red signifying that the knock sequences were different.
