ctribe/ECE411-Project/411 Project/nocLock/Documentaion/Test Plan/T02-Software_unit_test.odt

Setup:

Ports B0, B1, and B6 are active high input buttons. B0 is the program button, B1 is the action button, and B6 is the reset button. These ports should be grounded initially. Port ADC5 is the A to D converter for the piezo buzzer, which should also be grounded initially. Finally, ports B2, B3, and B4 are output pins. B2 is the solenoid driver, B3 is the green LED, and B4 is the red LED. The micro controller should be programmed with the executable compiled from nocLock.c. Port B4 should be outputting 5V, while ports B2 and B3 are outputting 0V.

Step | Action | Expected Result
1 | Pulse port B1 with 5V to simulate action button press | Port B2 and port B3 output 5V for five seconds. After five seconds, port B2 and B3 go to 0V and port B4 goes to 5V.
2 | Pulse port B0 with 5V to simulate program button press | Port B3 and B4 output 5V
3 | Pulse port ADC5 with 3V at 500ms intervals, four times
4 | Pulse port B0 with 5V to simulate program button press | Port B4 goes to 0V, and B3 goes to 5V for two seconds. After two seconds, B3 and B4 go back to 5V
5 | Pulse port ADC5 with 3V at 500ms intervals, four times
6 | Pulse port B0 with 5V to simulate program button press | Port B4 goes to 0V. Port B3 goes to 5V for two seconds. After two seconds, port B3 goes to 0V and B4 goes to 5V.
7 | Pulse port B0 with 5V to simulate program button press
8
9
10
