ctribe/ECE411-Project/411 Project/nocLock/Documentaion/Test Plan/Avg_nock.jpg

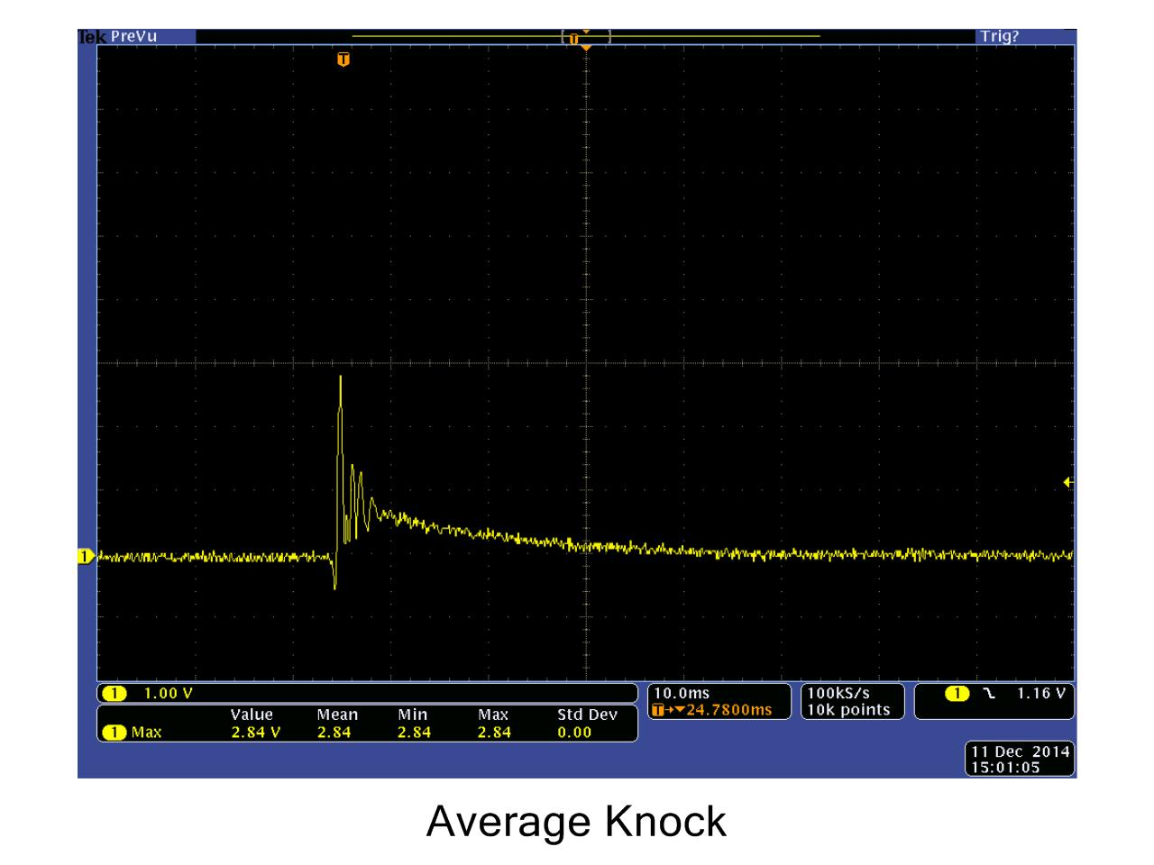
411 Project/nocLock/Documentaion/Test Plan/Avg_nock.jpg
