ctribe/ECE411-Project/411 Project/nocLock/100-Schematic/T02_noclock_rev3.brd

## EAGLE design 411 Project/nocLock/100-Schematic/T02_noclock_rev3.brd (2014-11-15)

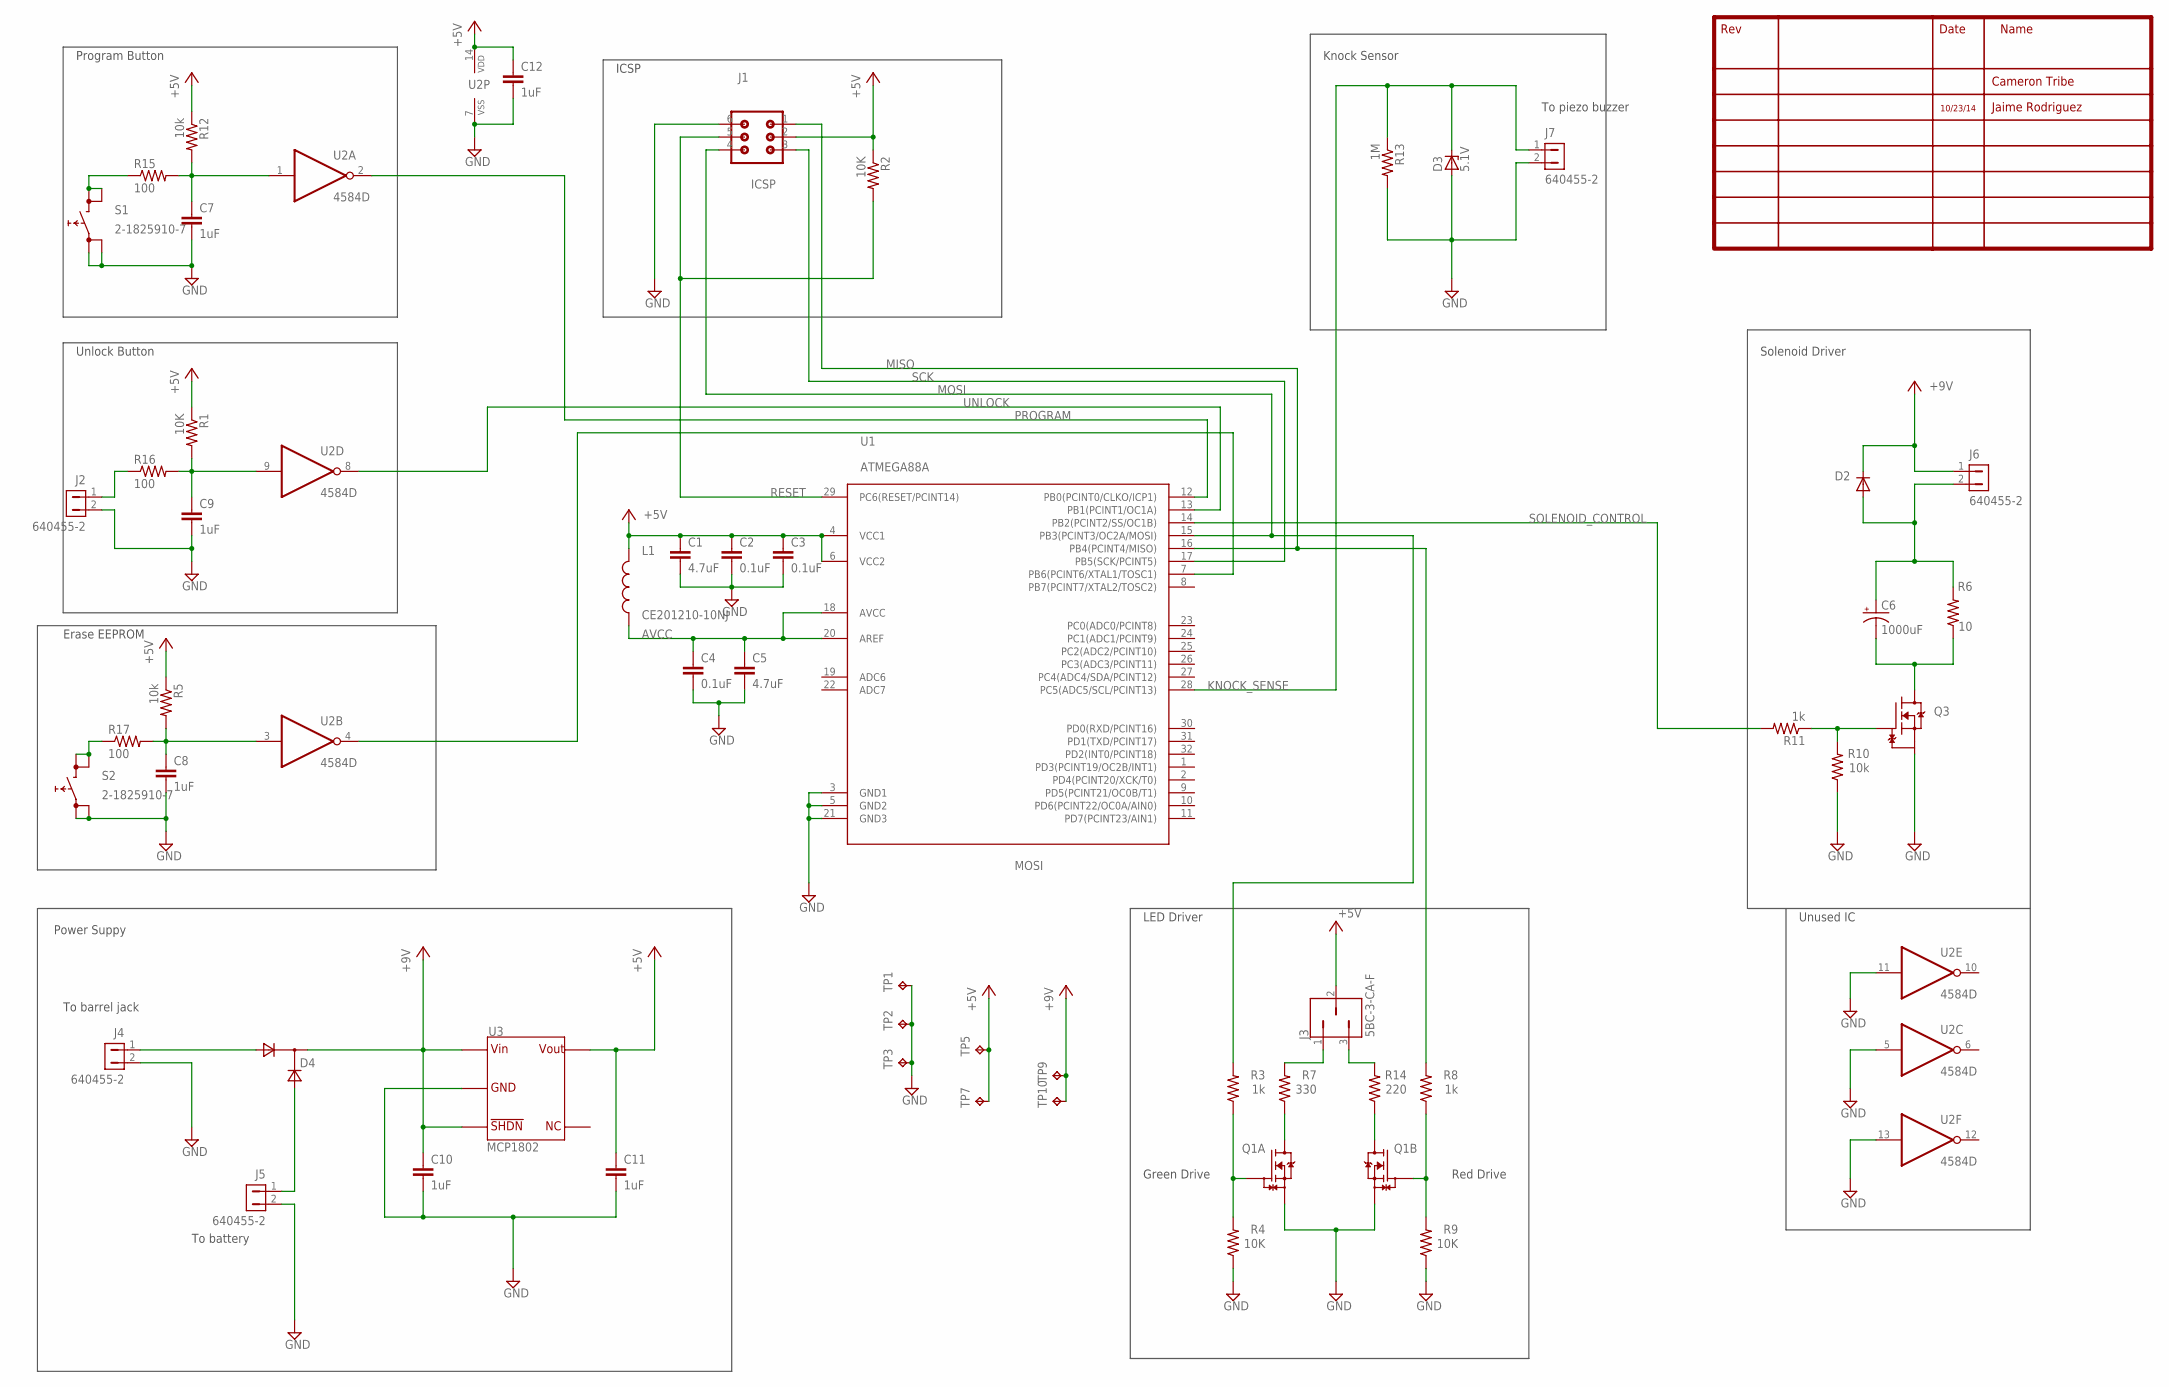
[picture p39: schematic T02_noclock_rev3.sch]

Parts:
C1, C5: 4.7uF; C0805; PARTNUM CL21A475KOFNNNE
C2, C3, C4: 0.1uF; C0805; PARTNUM GRM155R61A104KA01D
C6: 1000uF; EKY-100ELL102MH20D
C7, C8, C9, C10, C11, C12: 1uF; C0805; PARTNUM CL21B105KBFNNNE
D2: GF1; SMA-DO214AC; PARTNUM S1J
D3: 5.1V; SOT23; PARTNUM BZX84C4V7-TP
D4: PMEG2005CT,215; SOT-23; PARTNUM PMEG2005CT,215
J1: ICSP
J2, J4, J5, J6, J7: 640455-2; 2-PIN_CONNECTOR
J3: 5BC-3-CA-F; 3_PIN_CONNECTOR
L1: CE201210-10NJ; R0805
Q1: DMN63D8LDW-7; SOT363; PARTNUM DMN63D8LDW-7
Q3: DMG1012UW-7; SOT323; PARTNUM DMG1012UW-7
R1, R2, R4, R9: 10K; R0805; PARTNUM ESR10EZPJ103
R3, R8, R11: 1k; R0805; PARTNUM MCR10ERTF1001
R5, R10, R12: 10k; R0805; PARTNUM ESR10EZPJ103
R6: 10; R2512; PARTNUM CRM2512-JW-100ELF
R7: 330; R0805; PARTNUM MCR10ERTF3300
R13: 1M; R0805; PARTNUM RMCF0805JT1M00
R14: 220; R0805; PARTNUM RMCF0805FT220R
R15, R16, R17: 100; R0805; PARTNUM ESR10EZPJ103
S1, S2: 2-1825910-7; FSM14JH
TP1, TP2, TP3: TP; TP100SQ
TP5, TP7, TP9, TP10: TPTP19R; TP19R
U1: ATMEGA88A; TQFP32
U2: 4584D; SO14; PARTNUM 4584D
U3: MCP1802; SOT23-5; PARTNUM MCP1802

Connections:
9V: D4.3 (A1), J4.1
+5V: C1.1, C2.1, C3.1, C11.1, C12.1, J1.2, J3.2, L1.2, R1.1, R2.1, R5.1, R12.1, TP5.TP, TP7.TP, U1.4 (VCC1), U1.6 (VCC2), U2.14 (VDD), U3.5 (VOUT)
+9V: C10.1, D2.K (C), D4.2 (C), J6.1, TP9.TP, TP10.TP, U3.1 (VIN), U3.3 (SHDN)
AVCC: C4.1, C5.1, L1.1, U1.18 (AVCC), U1.20 (AREF)
BATT: D4.1 (A2), J5.1
GND: C1.2, C2.2, C3.2, C4.2, C5.2, C7.2, C8.2, C9.2, C10.2, C11.2, C12.2, D3.1 (A), J1.6, J2.2, J4.2, J5.2, J7.2, Q1.S1 (S), Q1.S2 (S), Q3.3 (S), R4.1, R9.1, R10.1, R13.2, S1.1, S1.2, S2.1, S2.2, TP1.P$1, TP2.P$1, TP3.P$1, U1.3 (GND1), U1.5 (GND2), U1.21 (GND3), U2.7 (VSS), U2.11 (I), U2.13 (I), U3.2 (GND)
KNOCK_SENSE: D3.3 (C), J7.1, R13.1, U1.28 (PC5(ADC5/SCL/PCINT13))
MISO: J1.1, R8.2, U1.16 (PB4(PCINT4/MISO))
MOSI: J1.4, R3.2, U1.15 (PB3(PCINT3/OC2A/MOSI))
unnamed: Q1.D1 (D), R7.1
unnamed: Q1.G2 (G), R8.1, R9.2
unnamed: C9.1, R1.2, R16.2, U2.9 (I)
unnamed: U1.7 (PB6(PCINT6/XTAL1/TOSC1)), U2.4 (O)
unnamed: J3.1, R7.2
unnamed: J3.3, R14.2
unnamed: R15.1, S1.3, S1.4
unnamed: Q1.D2 (D), R14.1
unnamed: Q3.2 (G), R10.2, R11.1
unnamed: C6.+, D2.A, J6.2, R6.2
unnamed: C6.-, Q3.1 (D), R6.1
unnamed: R17.1, S2.3, S2.4
unnamed: C8.1, R5.2, R17.2, U2.3 (I)
unnamed: J2.1, R16.1
unnamed: C7.1, R12.2, R15.2, U2.1 (I)
unnamed: Q1.G1 (G), R3.1, R4.2
PROGRAM: U1.12 (PB0(PCINT0/CLKO/ICP1)), U2.2 (O)
RESET: J1.5, R2.2, U1.29 (PC6(RESET/PCINT14))
SCK: J1.3, U1.17 (PB5(SCK/PCINT5))
SOLENOID_CONTROL: R11.2, U1.14 (PB2(PCINT2/SS/OC1B))
UNLOCK: U1.13 (PB1(PCINT1/OC1A)), U2.8 (O)

Notes on the sheet:
Solenoid Driver
Program Button
Erase EEPROM
Knock Sensor
Power Suppy
LED Driver
ICSP
Cameron Tribe
Jaime Rodriguez
10/23/14
Unlock Button
To battery
To barrel jack
To piezo buzzer
Unused IC
Green Drive
Red Drive

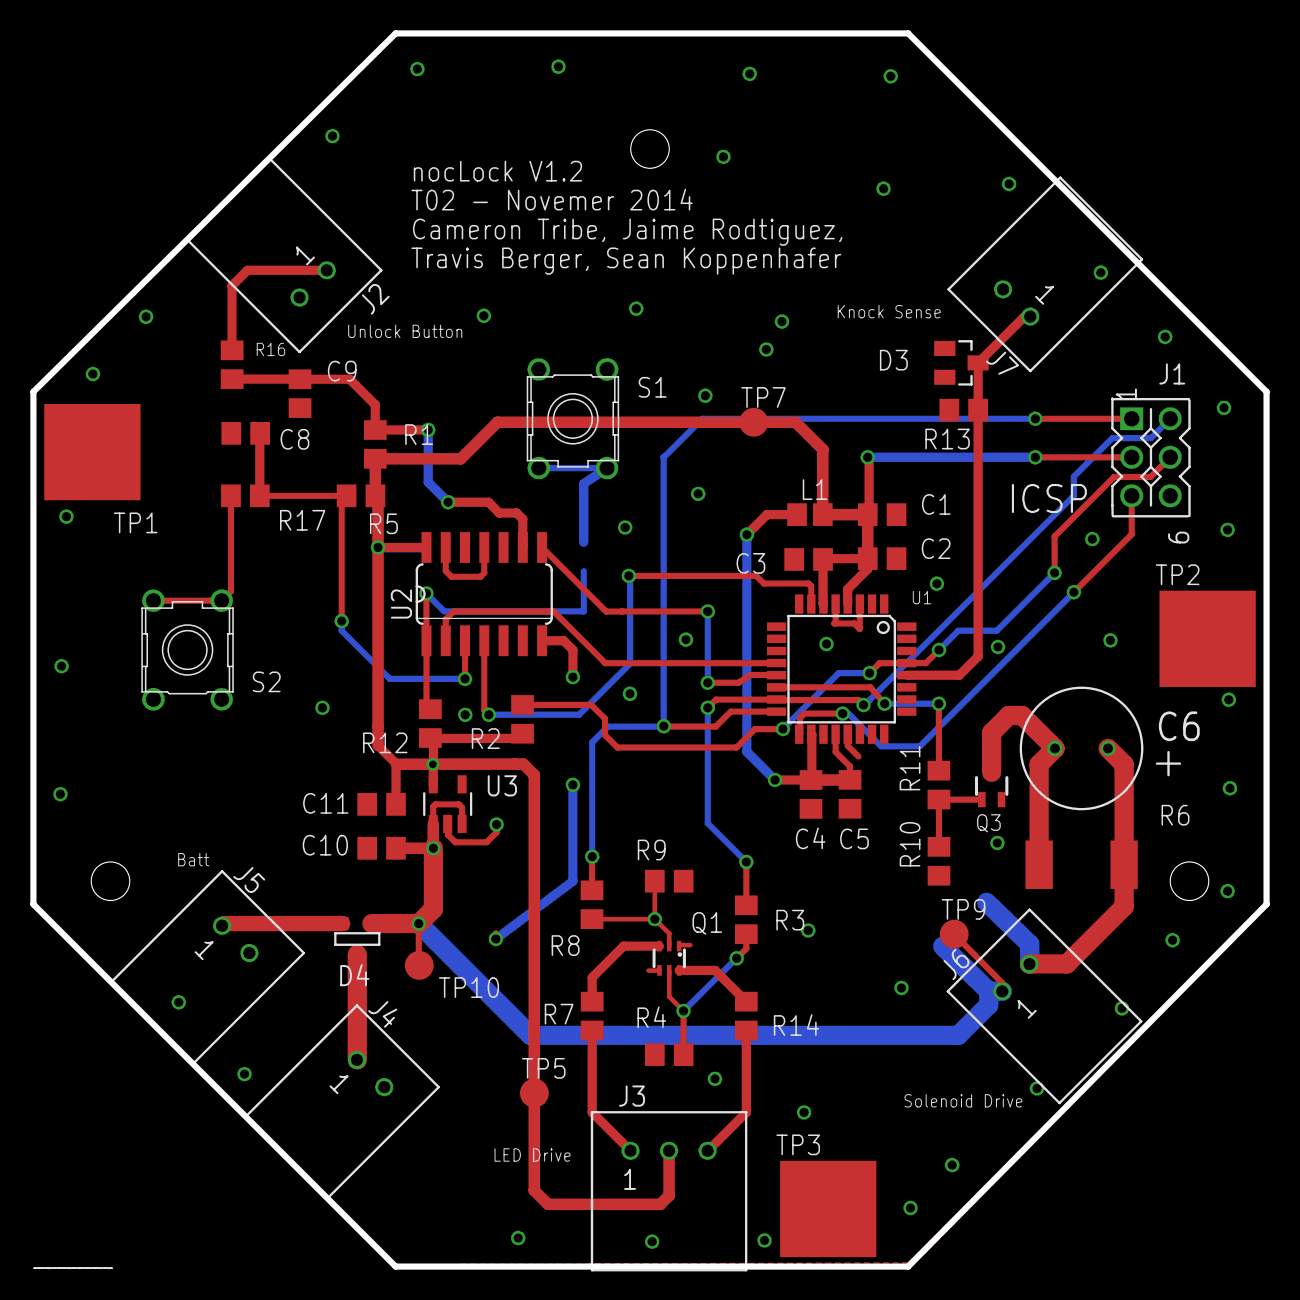
[picture p40: board T02_noclock_rev3.brd from above]

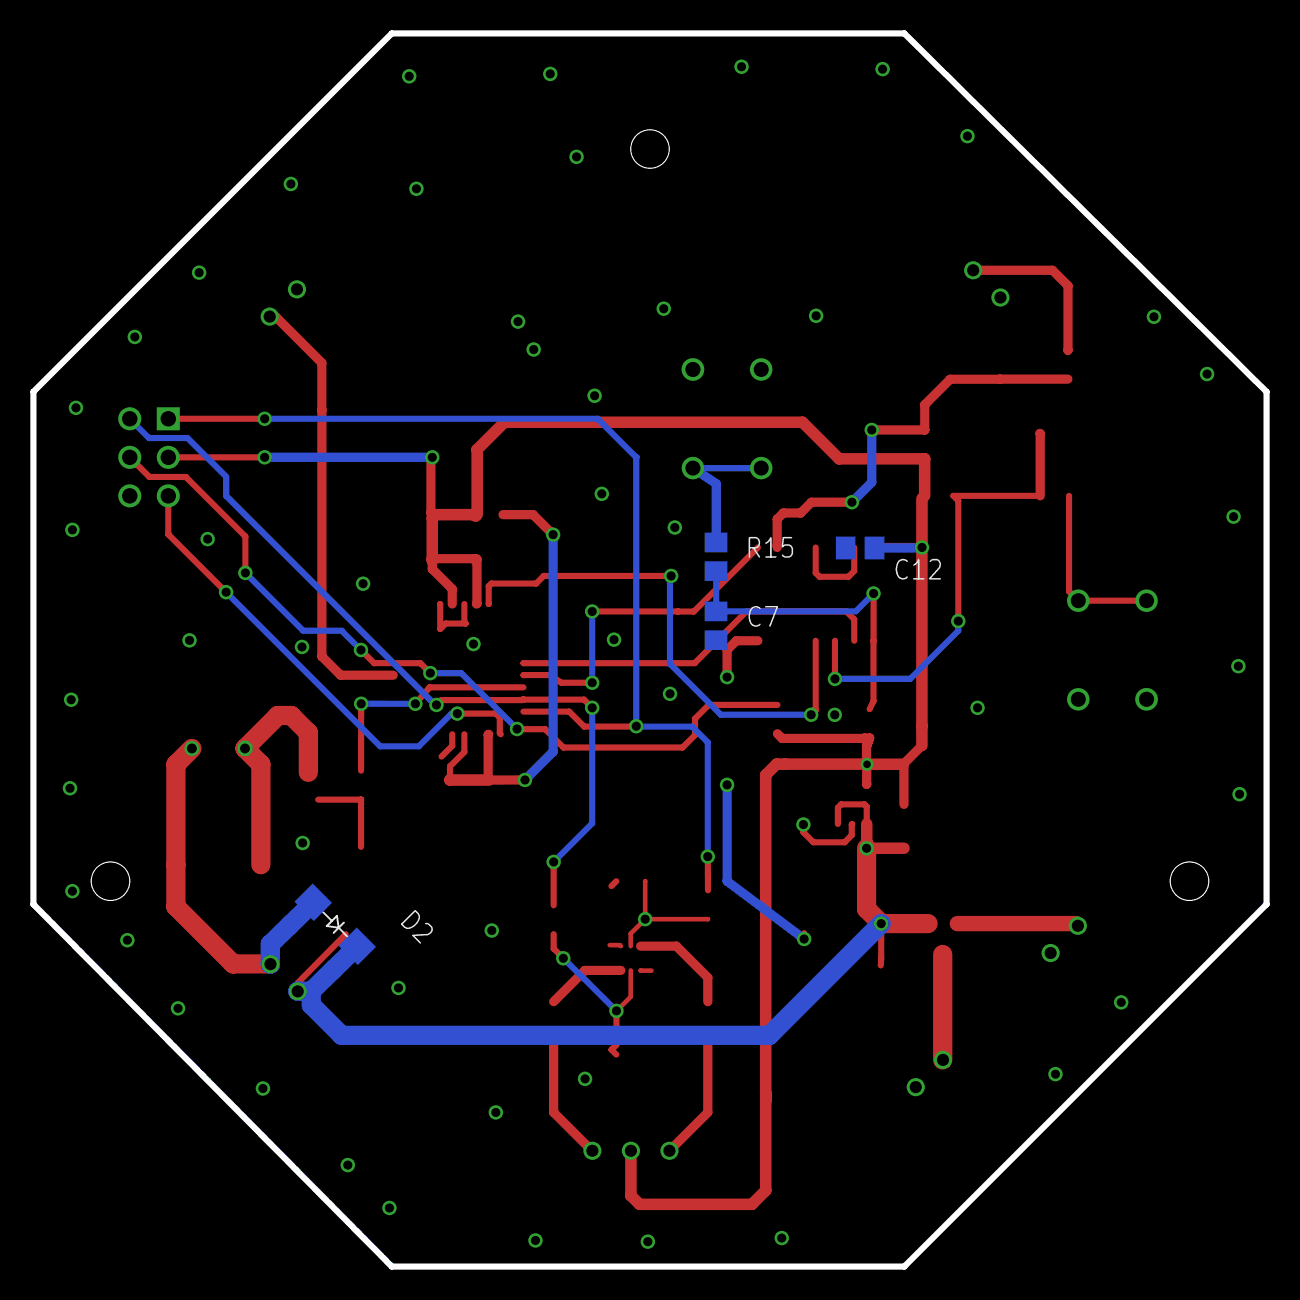
[picture p41: board T02_noclock_rev3.brd from below]

Board: 2 copper layers, 81.3 x 81.3 mm, 54 parts (4 on the bottom side), 30 nets.
