ctribe/ECE411-Project/(commit log)

2014-10-08 Changed timer to work with 8MHz clock and added eeprom knock storage
2014-10-08 Updated comment about timer resolution
2014-10-08 Jaime
    Added Project folders
    [Knock Lock BOM.xlsx]
2014-10-09 Corrected documentation directories.
    [Knock Lock BOM.xlsx]
2014-10-10 Corrected directory issues
    [KnockLockLogo.dxf]
2014-10-12 Updated BOM with major components.
    I also added all appropriate data sheets to the data sheets folder.
    [Knock Lock BOM.xlsx]
2014-10-12 Added more datasheets and updated BOM
    [Knock Lock BOM.xlsx]
2014-10-13 Jaime
    Added Schematic
    [Knock Lock BOM.xlsx, nocLock.sch]
2014-10-13 Added legacy version of BOM
    [Knock Lock BOM.xls]
2014-10-14 Added task list folder and file.
    [10_13_14 Task List.xls, Knock Lock BOM.xls]
2014-10-14 UART enabled for TX
2014-10-15 Eagle Library
    [Knock Lock BOM.xls]
2014-10-15 Case design
    [Knock Lock BOM.xls]
2014-10-15 Added lib and edited BOM
    [nocLock.sch]
2014-10-15 Updated BOM
    [Knock Lock BOM.xls]
2014-10-17 added more components to library.
    [nocLock.sch]
2014-10-17 schematic change
2014-10-19 Updated schematics, added parts to library.
2014-10-19 Updated schematic
    [nocLock.sch]
2014-10-20 Added parts - Jaime
    [Knock Lock BOM.xls]
2014-10-20 Updated Schematics
    [nocLock.sch]
2014-10-20 Created Library for Voltage Regulator
2014-10-20 Added schematic parts
    fixed LED common anode
    new connector added
    updated BOM
    [Knock Lock BOM.xls]
2014-10-23 Updated Schematics with additional circuitry.
    [nocLock.sch]
2014-10-23 Jaime
    Finished schematic and updated Library
    [Knock Lock BOM.xls, noclock_rev2.sch]
2014-10-26 Revert "Updated WPR"
    This reverts commit 3cfb1aeb726932070d7e07aaba60c330598cb72d.
    [nocLock_v2.c]
2014-10-26 Updated schematics and library
2014-10-28 added connectors
    [noclock_rev2.sch]
2014-10-29 Started Board Layout
    [Knock Lock BOM.xls, noclock_rev2.brd, noclock_rev2.sch]
2014-10-29 updated library
    [nocLock.sch, noclock_rev2.brd, noclock_rev2.sch, noclock_rev3.sch]
2014-10-30 Updated Schematic and Library
    added part numbers to all parts as attributes.
    [T02_noclock_rev3.sch]
2014-10-31 Debug timing issues and compare issues
    [T02_nocLock.c]
2014-11-01 Updated BOM for digikey order.
    [Knock Lock BOM.xls, T02_Board_Components_BOM.xlsx, T02_noclock_rev3_BOM.csv]
2014-11-03 Submitted PCB Rev 3
    [Knock Lock BOM.xls, T02_noclock_rev3.brd, T02_noclock_rev3.sch, nocLock_Rev1.brd, nocLock_Rev1.sch, noclock_rev3.sch]
2014-11-03 Added WPR for this week.
    [T02_noclock_rev3.sch]
2014-11-03 Fix schematic error.
    [T02_noclock_rev3.brd, T02_noclock_rev3.sch]
2014-11-03 LATEST FILES
    [T02_noclock_rev3.brd, T02_noclock_rev3.sch]
2014-11-03 Added +9V to part lib
2014-11-04 Revised PCB layout.
    Some work still needs to be done. Figure out a 5V power place rather
    than a single trace to all things 5V.
    [T02_noclock_rev1.brd, T02_noclock_rev1.sch, T02_noclock_rev3.brd]
2014-11-05 Board revision
    Fixed various issues with current layout, aded logo, and team name.
    [T02_noclock_rev1.brd, T02_noclock_rev1.sch, T02_noclock_rev3.sch]
2014-11-05 Fixing Schematic Error
    [T02_noclock_rev1.brd, T02_noclock_rev3.brd, T02_noclock_rev3.sch, nocLock_Rev1.brd, nocLock_Rev1.sch]
2014-11-05 Added good PCB and sch file
    [T02_noclock_rev3.brd, T02_noclock_rev3.sch]
2014-11-07 Active high buttons
2014-11-10 Added gerbers, added WPR, updated pcb logo
    [T02_noclock_rev3.brd]
2014-11-10 fix git
    [10_13_14 Task List.xls]
2014-11-10 fixing git
    [10_13_14 Task List.xls]
2014-11-14 Added New Directory for new HW assignment.
    Also Added block diagrams for the HW assignment
    [Knock Lock BOM.xls]
2014-11-14 added description tables for block diagram.
    [Description Table.xlsx]
2014-11-15 Fixed corrupt board file.
    [T02_noclock_rev3.brd]
2014-11-15 Created PCB Errors document
    [Description Table.xlsx]
2014-11-16 Updated documentation
    Modified Block diagrams and descriptions. Added another error to the
    PCB errors document.
    [Description Table.xlsx]
2014-11-17 Revert "fixing git"
    This reverts commit b19157635f1bddf96b37074ee97dd971ba43d72b.
    [10_13_14 Task List.xls, Description Table.xlsx, Knock Lock BOM.xls, Knock Lock BOM.xlsx, KnockLockLogo.dxf, T02_Board_Components_BOM.xlsx, T02_noclock_rev3_BOM.csv]
2014-11-17 fixed git
    [10_13_14 Task List.xls, Description Table.xlsx, Knock Lock BOM.xls, Knock Lock BOM.xlsx, KnockLockLogo.dxf, T02_Board_Components_BOM.xlsx, T02_noclock_rev3.brd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]
2014-11-17 Completed Description Table
    [Description Table.xlsx]
2014-11-22 Full software test case
2014-11-23 Removed unnecessary files, Added solenoid test doc
2014-11-23 Edited Solenoid Test Case
2014-11-24 Added Test Case 4.1
2014-11-24 Updated Test Case 7.1 / 1.7
2014-11-24 Updated Test Case 1.2
2014-11-27 Now blinks RED when a program combination fails to match
    [T02_nocLock.c]
2014-12-05 Changed button delay for outside button
2014-12-05 Added PCB Enclosure Drawing
2014-12-11 Updated BOM and cleansed up directories.
    [Knock Lock BOM.xls, Knock Lock BOM.xlsx, T02_Board_Components_BOM.xlsx, T02_noclock_rev3_BOM.csv]
2014-12-12 Changed delay after knock and tolerance for the knock acceptance window
    [T02_nocLock.c]
